anii76/smart-weather-station-iot/README.md

# Weather-station-iot

Created by:
- Anfal Bourouina
- Wilem Lamdani
- Kenza Makhloufi
- Linda Belkessa

Architecture : 

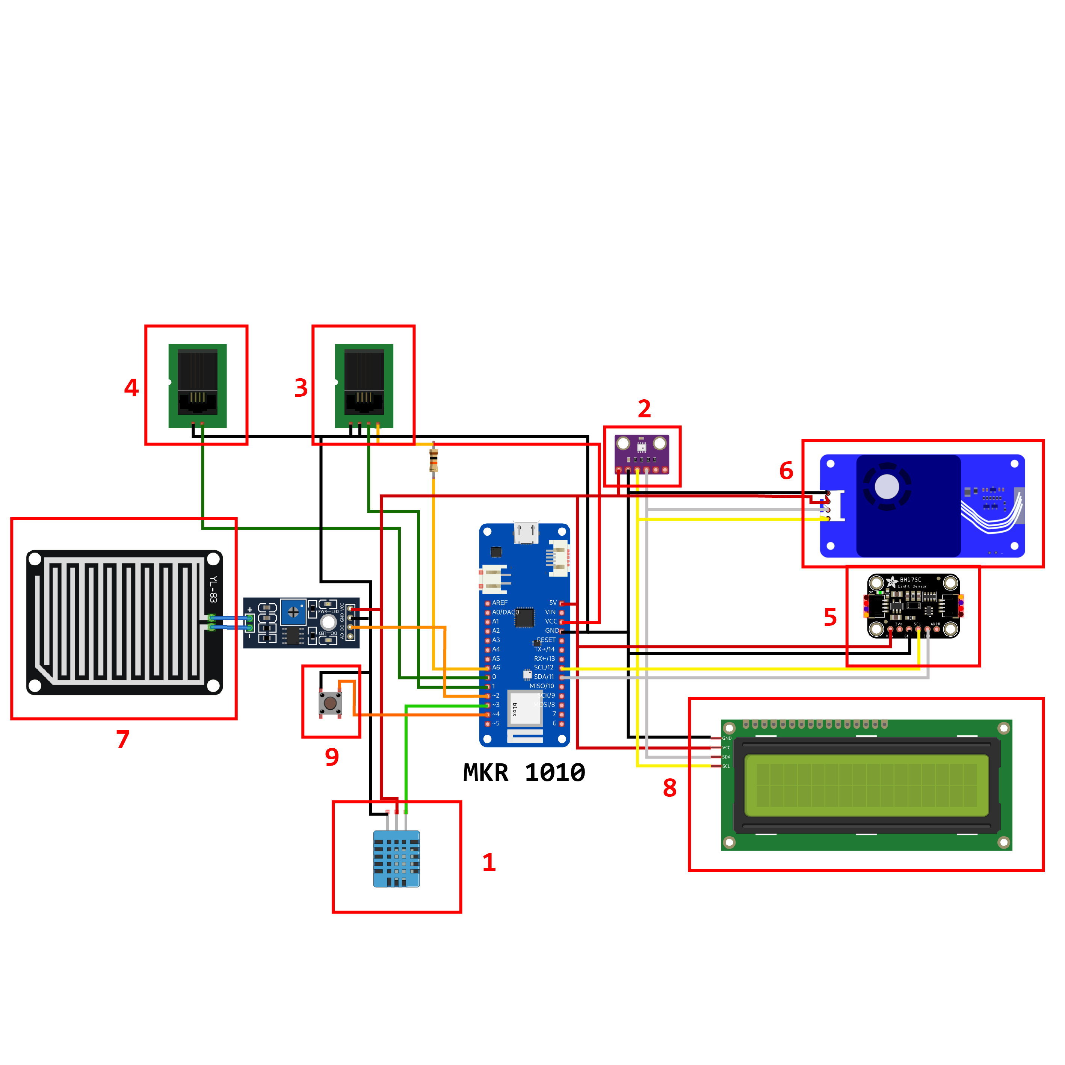
[picture p1: images/architecture.png]


Setup :

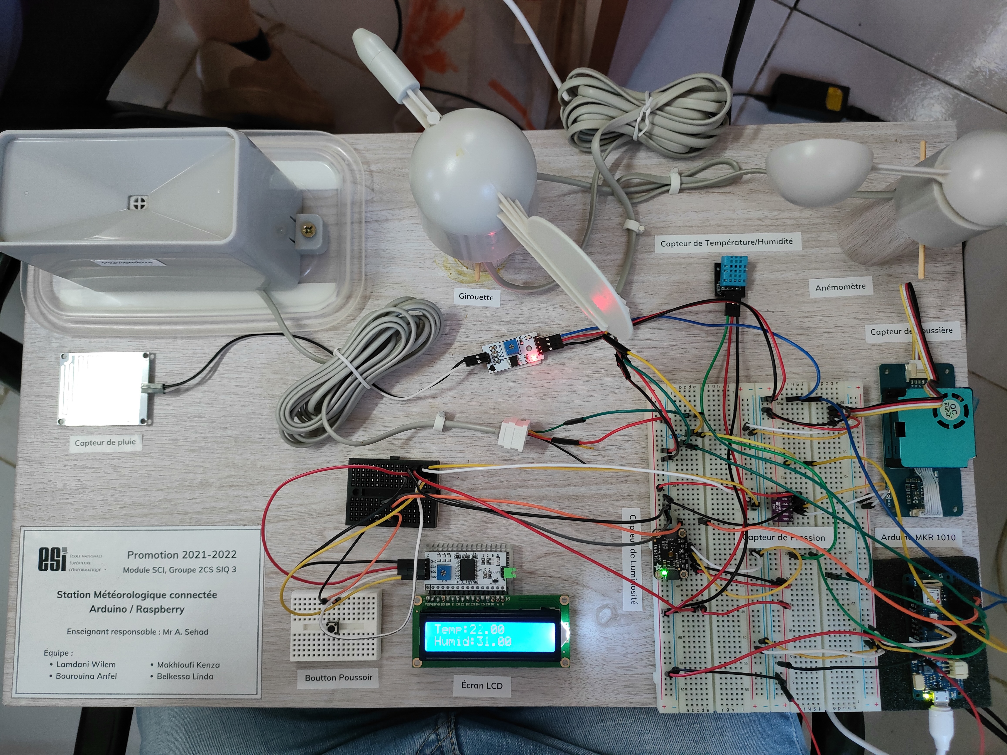
[picture p2: images/setup.jpg]
