anii76/smart-weather-station-iot/(commit log)

2022-06-29 arduino and node-red setup
2024-07-30 Rename Détails schéma@2x.png to setup.png
